yawangjiang/robot-arm-vision-sorting/hardware/AIC-2025-98061736机械臂结构拓扑优化方案.STEP

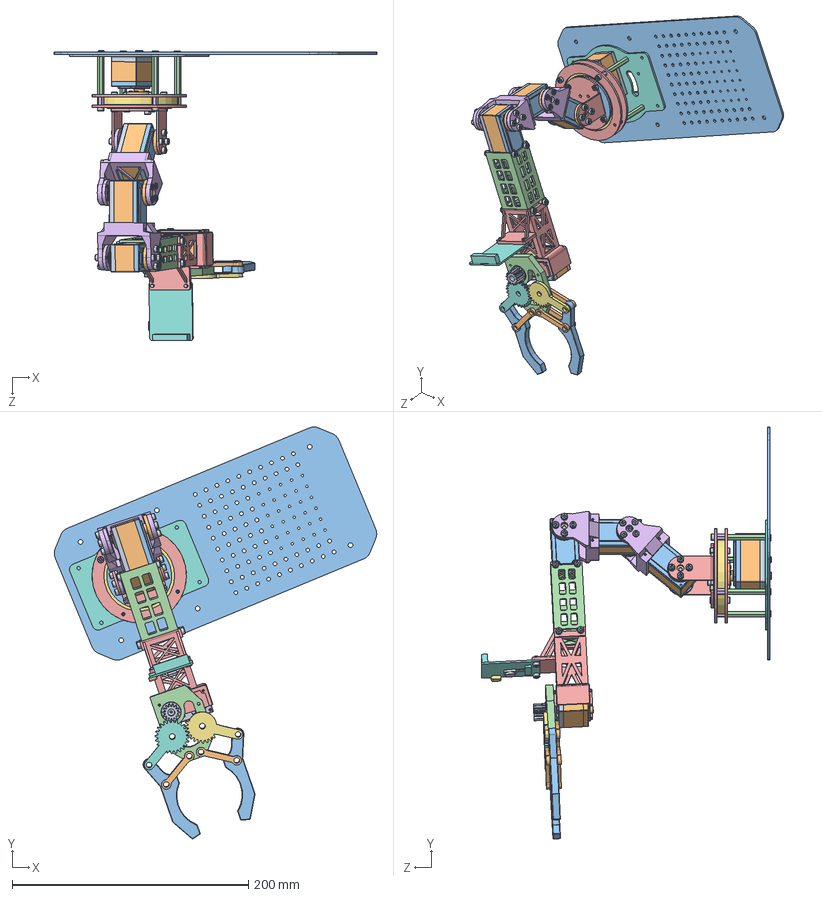
[picture p49: CAD file, 2026-10-28]
hardware/AIC-2025-98061736机械臂结构拓扑优化方案.STEP
273.0 x 348.7 x 245.6 mm
YB-SD15M-Bottom-Cover-LD v2_默认 x 4
YB-SD15M-Middle-Cover-LD v2_默认 x 4
YB-SD15M-Top-Cover-LD v3_默认 x 4
HexStandoff-32mm-M2_5 v2_默认 x 4
RingBase-Part-1 v2_默认 x 2
HexStandoff-7mm_ig_ig_M3 v2_默认 x 4
Sealed-Ball-Bearing-50x65x7mm v1_默认
机械臂转接板_默认
hexagon socket head cap screws gb_GB_FASTENER_SCREWS_HSHCS M3X6-N_默认 x 55
RudderDisk v2_默认 x 5
RotationDisk-Part-3 v2_默认 x 2
CylindricalSpacer-7mm v3_默认 x 4
BaseLink-Shaft-Bracket v2_默认
AuxRudderDisk v2_默认 x 3
OpenMV4-PCB_默认
夹爪舵机_默认
ArmBasePlate v2_默认
手爪及OPENMV（长脖子加强版）_默认
手爪及OPENMV（短版最终结果加强版）_默认
关节转接件缩短版（超级加强版）_默认 x 2
Engrenagem Parcial_Valor predeterminado
Engrenagem completa_Valor predeterminado
Engrenagem Motor_Valor predeterminado
Ligação Garra OK_Valor predeterminado x 6
Dedo da Garra Movel_Valor predeterminado x 2
Suporte da Garra_Valor predeterminado
